Rimon06/RVLeon/PCB/gerbers/serigrafia.pdf

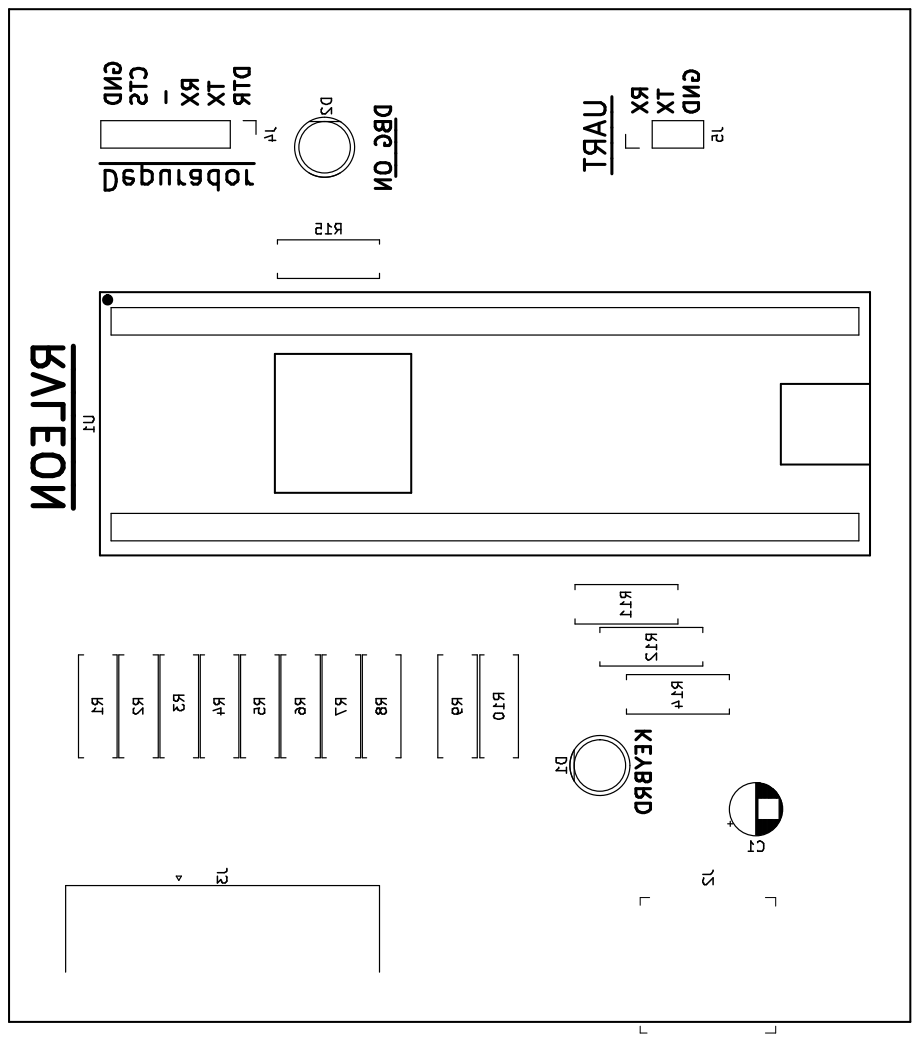
[picture p1: page 1]
