Rimon06/RVLeon/PCB/3d_model/FTDI USB to TTL Serial Adapter.stp

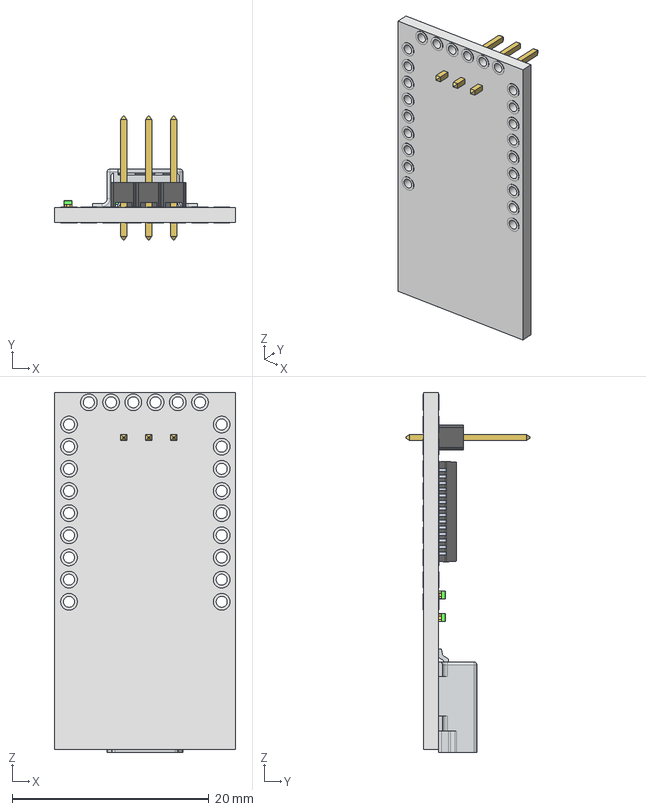
[picture p2: CAD file, 2024-03-22]
PCB/3d_model/FTDI USB to TTL Serial Adapter.stp
18.4 x 12.6 x 36.5 mm
SerialAdaptor PCB
Mini USB
ssop28_model
LED 0603 single color x 3
Male Header 2.54mm Pitch 3x1
