Rimon06/RVLeon/PCB/3d_model/lot_of_ram.step

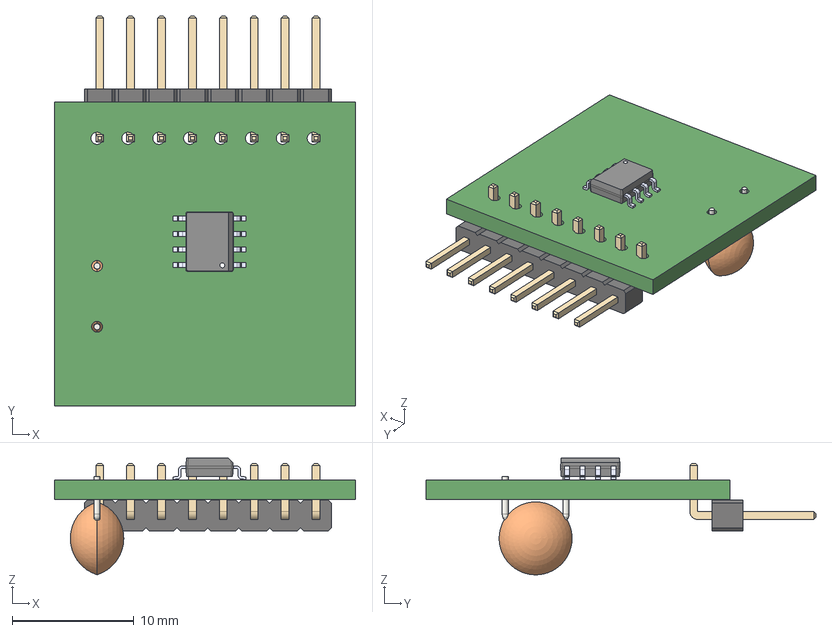
[picture p3: CAD file, 2024-03-22]
PCB/3d_model/lot_of_ram.step
24.8 x 32.0 x 9.60 mm
