Rimon06/RVLeon/PCB/gerbers/leonrv-F.SilkS.pdf

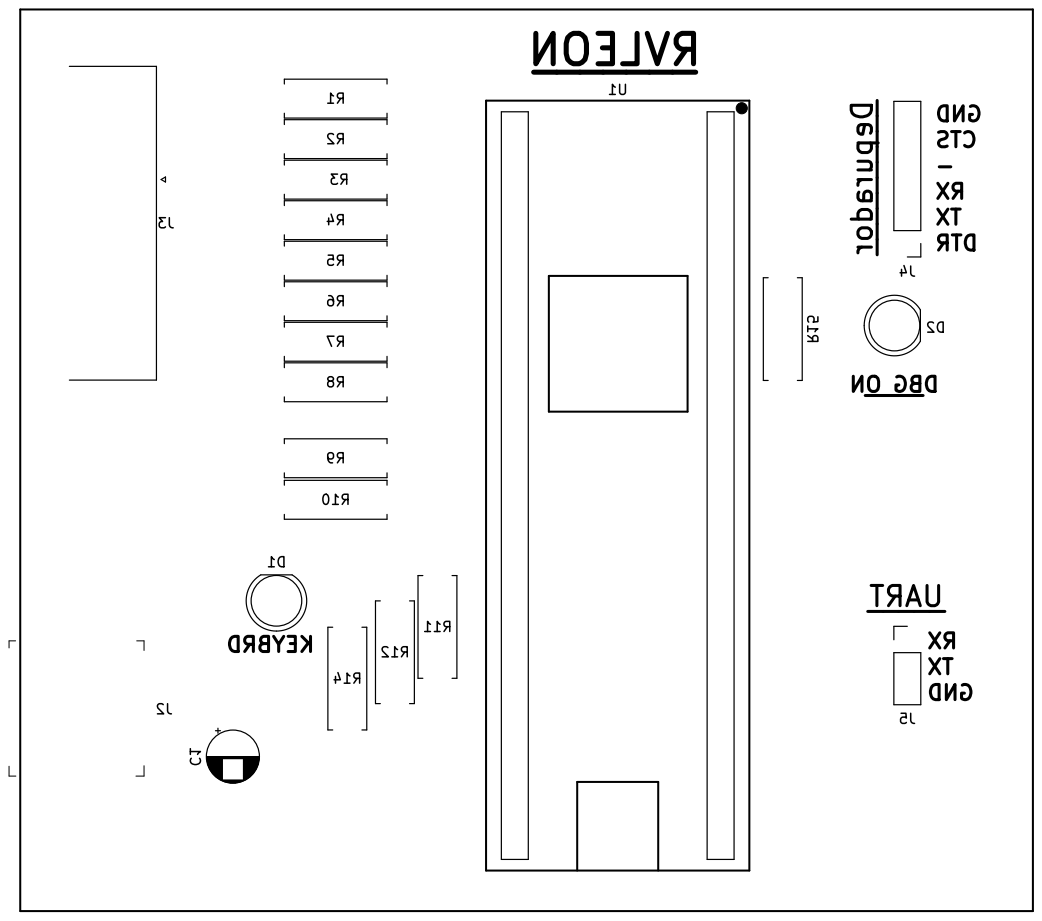
[picture p4: page 1]

TX GND Depurador GND
