Rimon06/RVLeon/PCB/leonrv.pdf

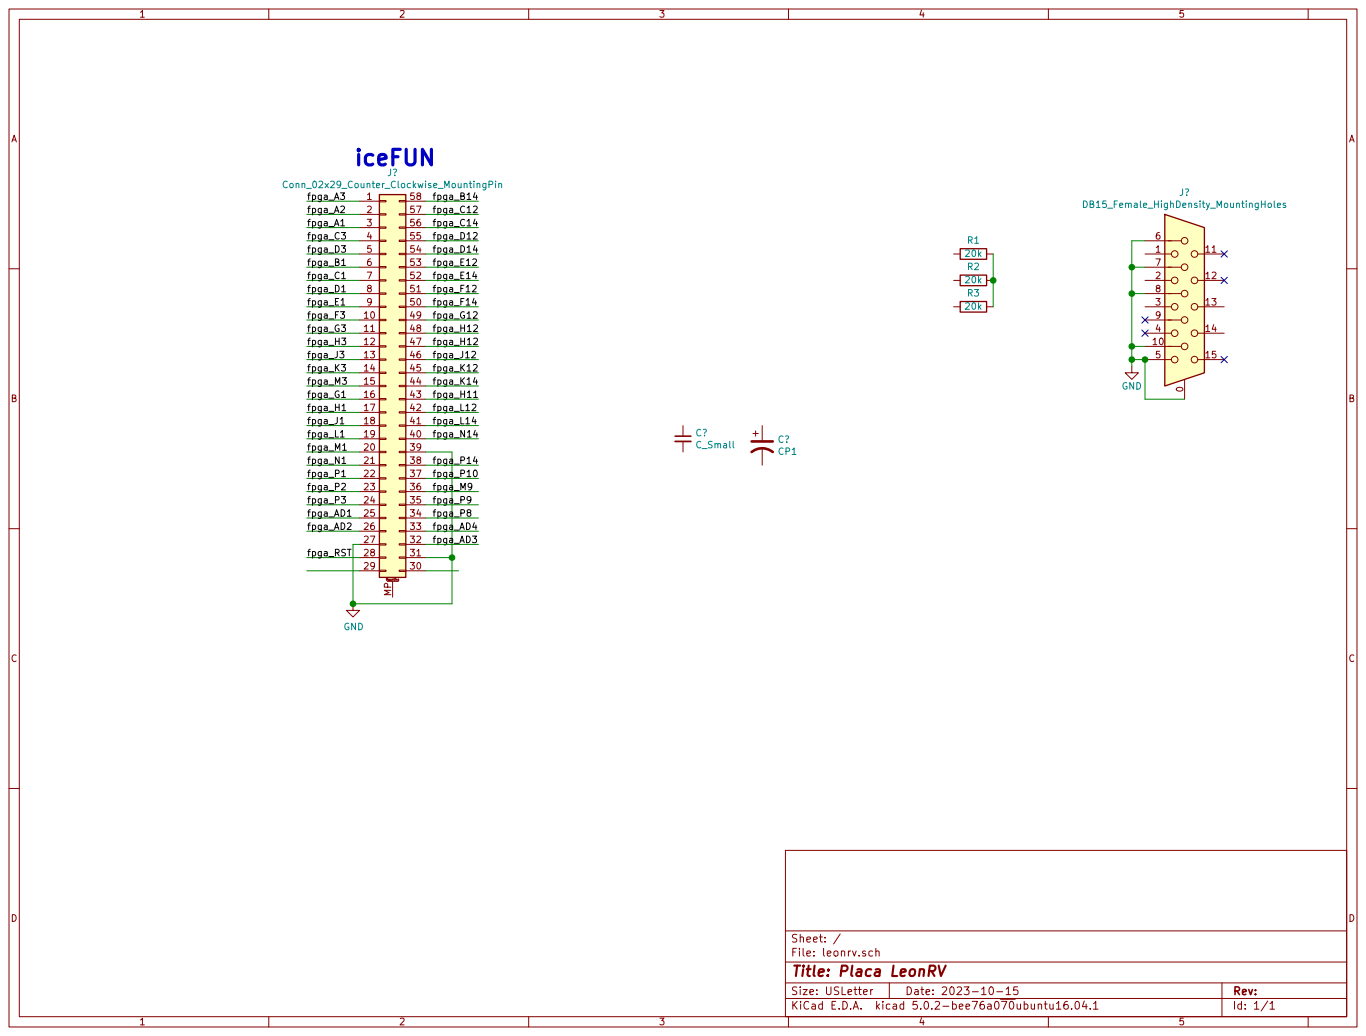
[picture p5: page 1]

File: leonrv.sch Sheet: /
Id: 1/1 Title: Placa LeonRV
