Rimon06/RVLeon/PCB/gerbers/leonrv-B.Cu.pdf

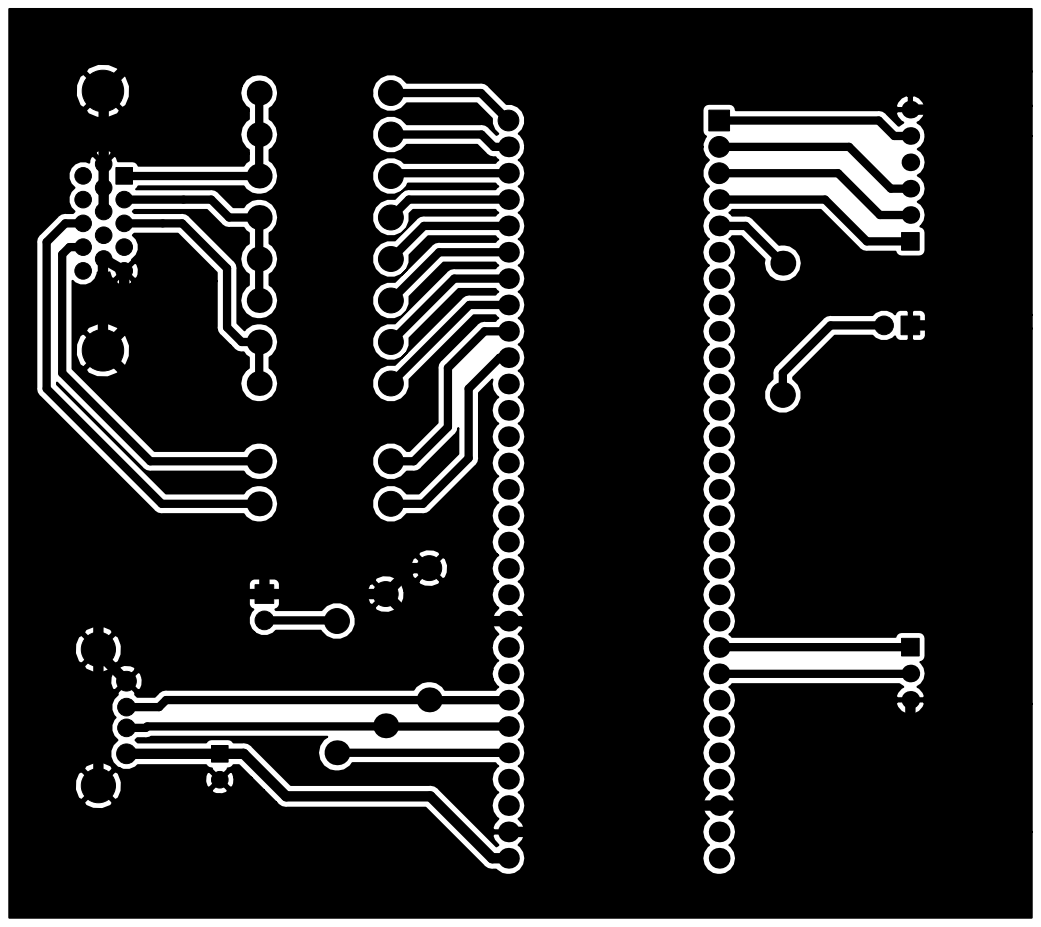
[picture p6: page 1]
