Rimon06/RVLeon/PCB/gerbers/leonrv-B.Mask.pdf

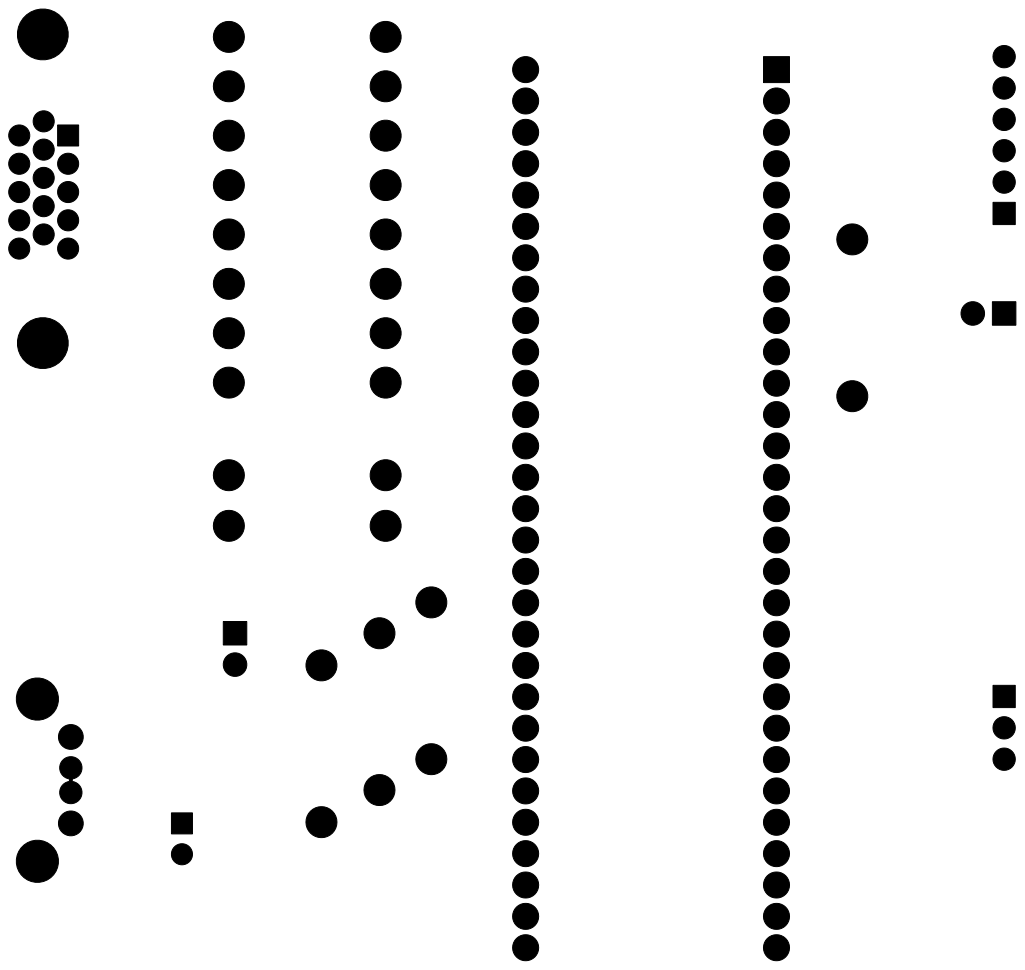
[picture p7: page 1]
