Rimon06/RVLeon/PCB/gerbers/leonrv-F.Cu.pdf

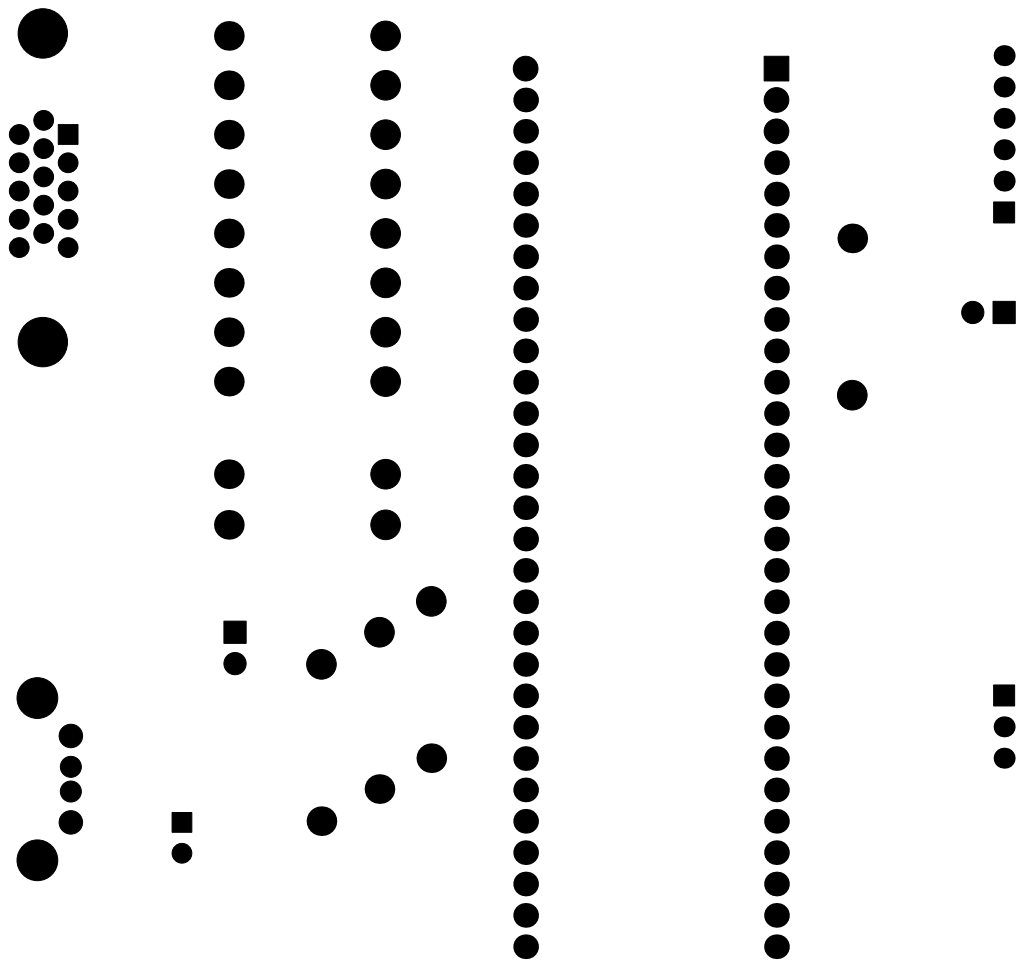
[picture p8: page 1]
