Rimon06/RVLeon/PCB/leonrv.kicad_pcb

## KiCad design PCB/leonrv.kicad_pcb (2024-03-22)

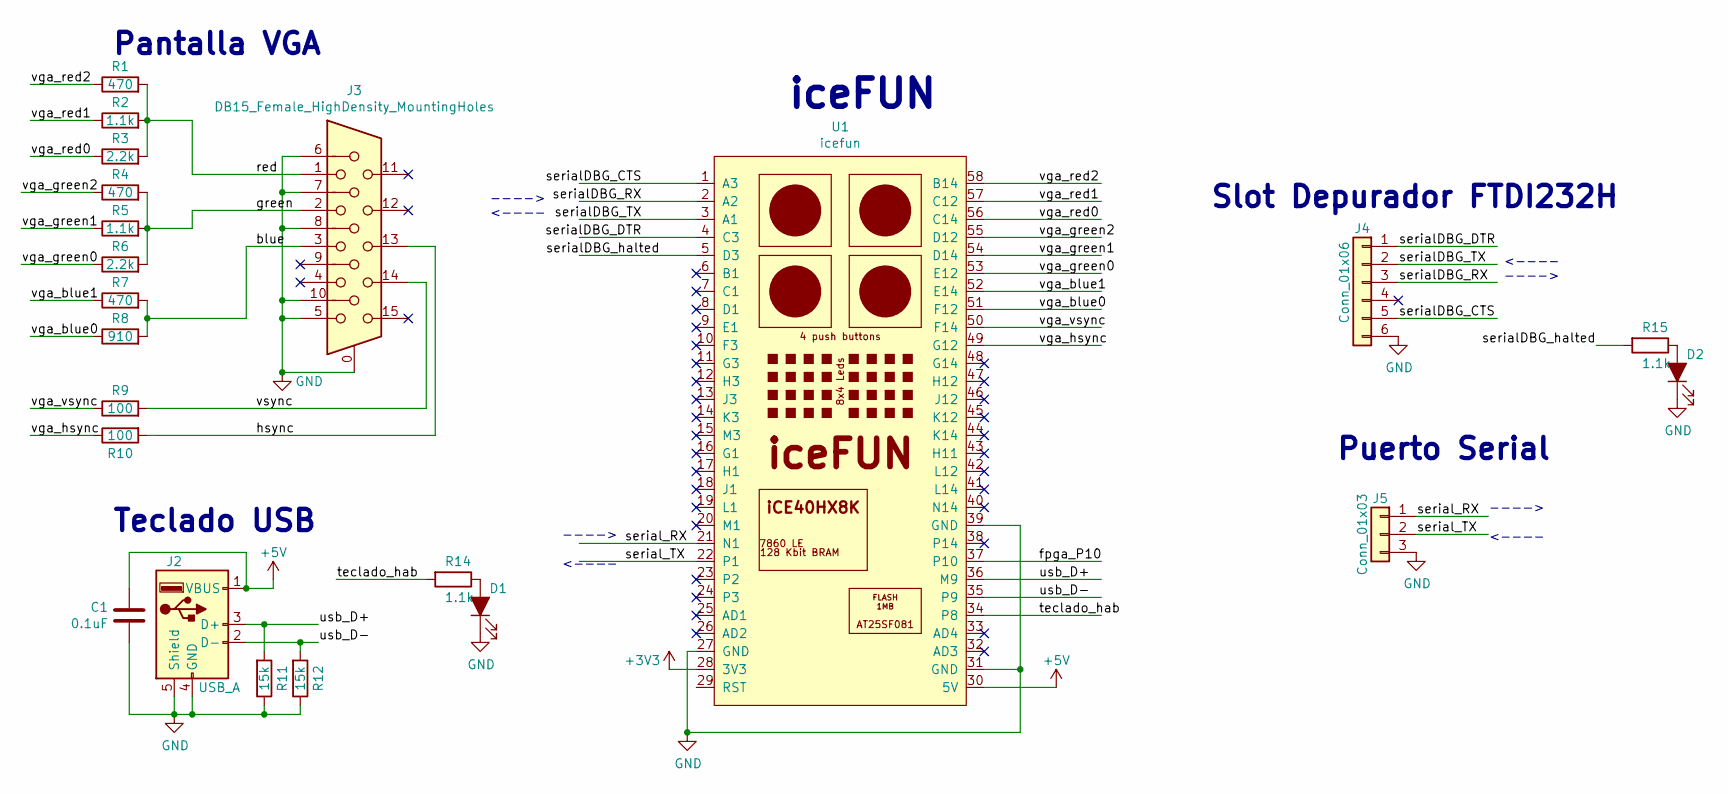
[picture p9: schematic leonrv.sch, RVLeon: Modulo de Computacion]

Parts:
C1: 0.1uF; CP_Radial_D5.0mm_P2.50mm
D1, D2: LED_ALT; LED_D5.0mm
J2: USB_A; USB_A_Female_UE27AC54100
J3: DB15_Female_HighDensity_MountingHoles; DSUB-15-HD_Female_Horizontal_P2.29x1.98mm_EdgePinOffset3.03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
J4: Conn_01x06; PinSocket_1x06_P2.54mm_Vertical
J5: Conn_01x03; PinSocket_1x03_P2.54mm_Vertical
R1, R4, R7: 470; R_Axial_DIN0411_L9.9mm_D3.6mm_P12.70mm_Horizontal
R2, R5, R14, R15: 1.1k; R_Axial_DIN0411_L9.9mm_D3.6mm_P12.70mm_Horizontal
R3, R6: 2.2k; R_Axial_DIN0411_L9.9mm_D3.6mm_P12.70mm_Horizontal
R8: 910; R_Axial_DIN0411_L9.9mm_D3.6mm_P12.70mm_Horizontal
R9, R10: 100; R_Axial_DIN0411_L9.9mm_D3.6mm_P12.70mm_Horizontal
R11, R12: 15k; R_Axial_DIN0411_L9.9mm_D3.6mm_P12.70mm_Horizontal
U1: icefun; icefun-DIP

Connections:
+3V3: U1.28 (3V3)
+5V: C1.2, J2.1 (VBUS), U1.30 (5V)
/blue: J3.3, R7.2, R8.2
/fpga_P10: U1.37 (P10)
/green: J3.2, R4.2, R5.2, R6.2
/hsync: J3.13, R10.2
/red: J3.1, R1.2, R2.2, R3.2
/serialDBG_CTS: J4.5, U1.1 (A3)
/serialDBG_DTR: J4.1, U1.4 (C3)
/serialDBG_RX: J4.3, U1.2 (A2)
/serialDBG_TX: J4.2, U1.3 (A1)
/serialDBG_halted: R15.2, U1.5 (D3)
/serial_RX: J5.1, U1.21 (N1)
/serial_TX: J5.2, U1.22 (P1)
/teclado_hab: R14.2, U1.34 (P8)
/usb_D+: J2.3 (D+), R11.2, U1.36 (M9)
/usb_D-: J2.2 (D-), R12.2, U1.35 (P9)
/vga_blue0: R8.1, U1.51 (F12)
/vga_blue1: R7.1, U1.52 (E14)
/vga_green0: R6.1, U1.53 (E12)
/vga_green1: R5.1, U1.54 (D14)
/vga_green2: R4.1, U1.55 (D12)
/vga_hsync: R10.1, U1.49 (G12)
/vga_red0: R3.1, U1.56 (C14)
/vga_red1: R2.1, U1.57 (C12)
/vga_red2: R1.1, U1.58 (B14)
/vga_vsync: R9.1, U1.50 (F14)
/vsync: J3.14, R9.2
GND: C1.1, D1.1 (K), D2.1 (K), J2.4 (GND), J2.5 (Shield), J3.0, J3.5, J3.6, J3.7, J3.8, J3.10, J4.6, J5.3, R11.1, R12.1, U1.27 (GND), U1.31 (GND), U1.39 (GND)
unnamed: D1.2 (A), R14.1
unnamed: D2.2 (A), R15.1

Notes on the sheet:
iceFUN
Teclado USB
Pantalla VGA
Slot Depurador FTDI232H
Puerto Serial
----> <----
----> <----
<---- ---->

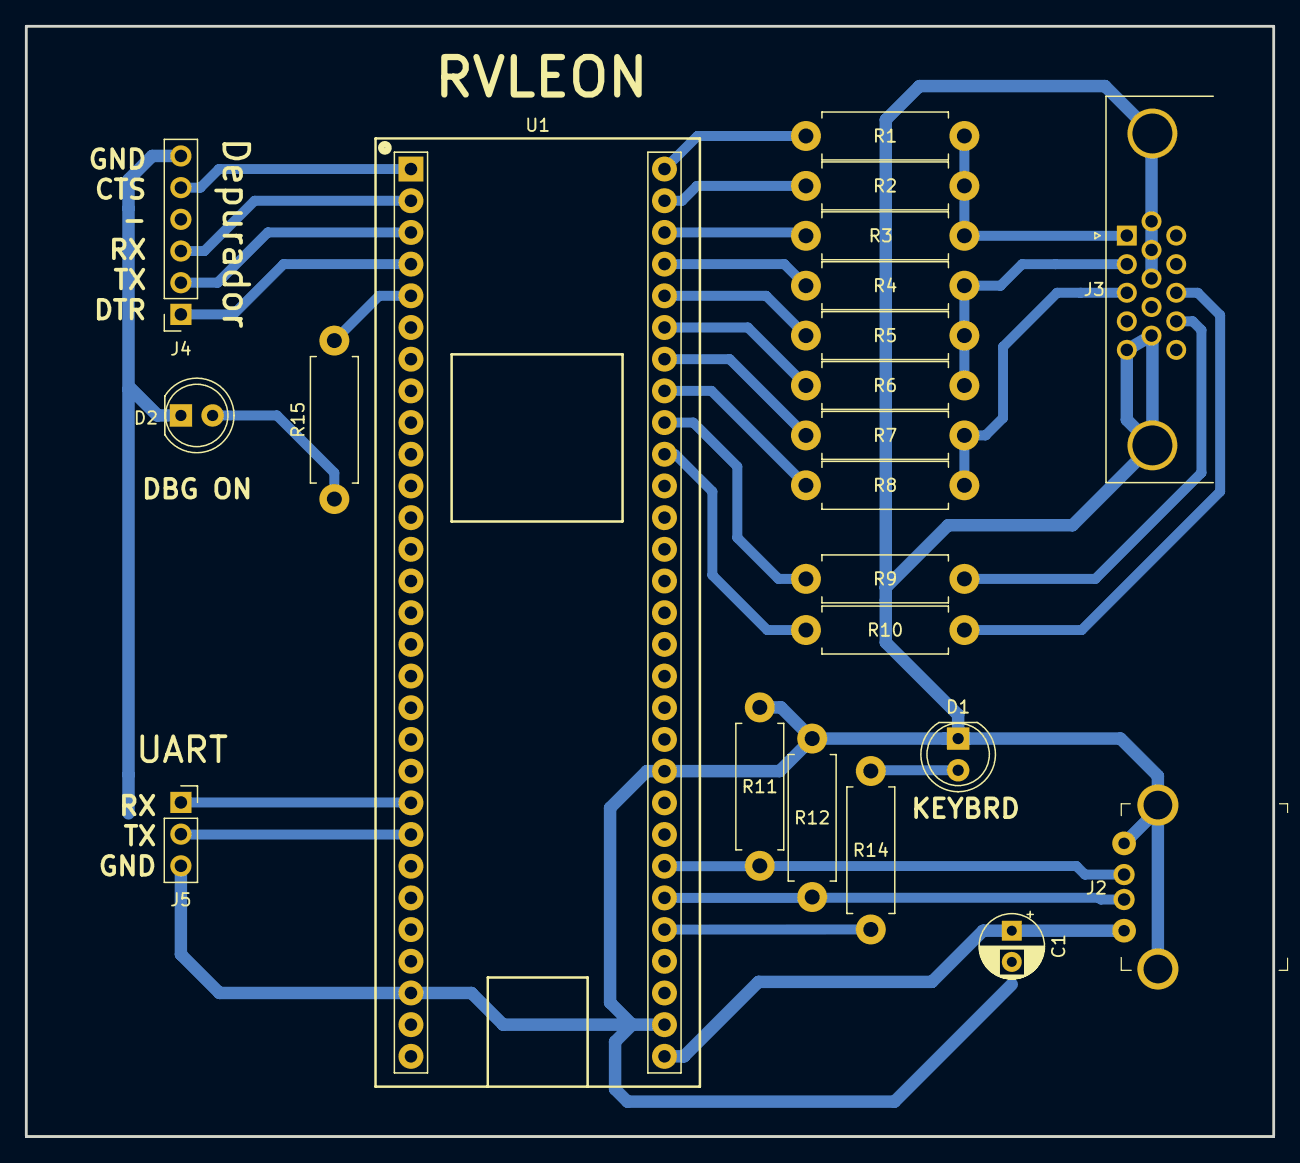
[picture p10: board leonrv.kicad_pcb from above]

Board: 2 copper layers, 100.0 x 89.0 mm, 22 parts (0 on the bottom side), 29 nets.
